XavierianAerospace/Wind_Tunnel_Proyect/Túnel_de_viento.pdf

Diseno Conceptual de T ˜ | unel de Viento de R ´ | afagas ´
para Pruebas Aerodinamicas Subs ´ | onicas ´
Julian Camilo Aranda Garc ´ | ía
Semillero XAE (Xaverian Aerospace Engineering) Pontificia Universidad Javeriana Bogota, Colombia ´

Resumen—El presente documento detalla la justificacion, me- ´
todología y secuencia de diseno de un t ˜ | unel de viento subs ´ | oni- ´
co tipo rafaga (blowdown). El objetivo del t ´ | | unel es permitir ´
la experimentacion y validaci ´ | on aerodin ´ | amica de modelos de ´
cohetería a velocidades aproximadas de 400 km/h. Se plantea una metodología de diseno inverso, partiendo de las restricciones ˜
geometricas de la secci ´ | on de pruebas hacia los sistemas de ´
suministro de presion. ´
Palabras clave—Aerodinamica subs ´ | onica, dise ´ | no inverso, m ˜ | eto- ´
do de Morel, tobera, tunel de r ´ | afaga. ´
I. JUSTIFICACION DEL ´ | MODELO: TUNEL ´ | TIPO RAFAGA ´

Para alcanzar velocidades de prueba de 400 km/h (Mach
≈ 0,32), un tunel de viento de circuito continuo requerir ´ | | | ía una
planta motriz de dimensiones y consumo electrico que exceden ´
la viabilidad tecnica y financiera est ´ | andar de un laboratorio ´
universitario.
Por ello, se ha optado por implementar un modelo tipo rafaga ( ´ blowdown). Este sistema almacena aire a alta presion´ en un tanque mediante un compresor de menor potencia y lo libera controladamente. Esto permite alcanzar las altas velocidades requeridas durante ventanas de tiempo lo suficientemente amplias para la recoleccion de datos mediante ´ sensores de alta tasa de muestreo, optimizando así los recursos espaciales y presupuestales.

II. METODOLOGÍA DE DISENÕ

En aerodinamica, el dimensionamiento de un t ´ | unel de viento ´
se rige por las necesidades de la seccion en la que se evaluar ´ | á
el modelo. Por lo tanto, se ha establecido una metodología de
diseno en orden inverso al flujo del aire, partiendo de la ˜ | unica ´
restriccion geom ´ | etrica inamovible: una secci ´ | on de pruebas con ´
un diametro fijo de ´ | 300 mm.
La secuencia de diseno estructurada es la siguiente: ˜
1. Diseno de la tobera (cono de contracci ˜ | | on). ´
2. Dimensionamiento de la camara de estabilizaci ´ | on. ´
3. Diseno del difusor. ˜
4. Especificacion del tanque de almacenamiento y grupo ´ motocompresor.

III. SECUENCIA Y DESARROLLO DE COMPONENTES

III-A. Tobera de Contraccion´

La tobera tiene la funcion de acelerar el flujo de aire ´
desde la camara de estabilizaci ´ | on hasta la secci ´ | on de pruebas, ´
minimizando las perdidas de presi ´ | on y asegurando un perfil ´
de velocidad uniforme.
En aerodinamica, la Relaci ´ | on de Contracci ´ | on ( ´ | CR) se
define como la proporcion entre las ´ | areas de las secciones ´
transversales de entrada (Ain) y salida (Aout), no linealmente
entre sus diametros. La relaci ´ | on geom ´ | etrica est ´ | a regida por la ´
siguiente expresion: ´

CR =

Ain

Aout

=

π
4 D²
in
π
4 D²
out

=

(︃
Din

Dout )︃2
(1)
Despejando el diametro de entrada ( ´ | Din) para una seccion´
de pruebas restringida a Dout = 300 mm y un CR objetivo de 9:

Din =

√
9 · 300 mm = 3 · 300 mm = 900 mm | (2)
Para la definicion geom ´ | etrica del perfil de contracci ´ | on, se ´
implemento el m ´ | etodo anal ´ | ítico propuesto por Thomas Morel
(1975). Este metodo reemplaza los polinomios de un solo ´ grado por dos curvas cubicas que se acoplan suavemente en un ´ punto de empalme o inflexion ( ´ Xm). Esto permite un control estricto sobre los gradientes de presion adversos en las paredes, ´ mitigando drasticamente el riesgo de desprendimiento de la ´ capa límite (boundary layer separation).
Físicamente, la primera curva (concava) contiene al fluido ´
para iniciar su aceleracion sin descensos bruscos de presi ´ | on´
en la pared, mientras que la segunda curva (convexa) alinea las líneas de corriente para que el aire ingrese a la seccion de ´ pruebas de forma perfectamente horizontal. Las ecuaciones que rigen el perfil radial y(x) a lo largo de la longitud L de la tobera estan definidas por estas dos zonas: ´
Para la zona de entrada (0 ≤ x ≤ Xm):

y1(x) = Rin − C1x

3
(3)

Para la zona de salida (Xm < x ≤ L):

y2(x) = Rout + C2(L − x)

3
(4)

Donde Rin y Rout son los radios de entrada y salida
respectivamente. Los coeficientes geometricos ´ | C1 y C2 se
calculan garantizando que tanto el valor posicional como la pendiente de ambas curvas sean matematicamente continuos ´ en el punto de inflexion´ Xm:

C1 =

Rin − Rout
X²
m · L

(5)

C2 =

Rin − Rout
(L − Xm)

2 · L

(6)

Para el dimensionamiento actual, se establecio una longitud ´ total L = 900 mm (cumpliendo con la relacion´ L/Din = 1) y
un punto de inflexion ubicado en el 55 % de la longitud ( ´ | Xm =
495 mm). Esta asimetría proporciona una zona concava inicial ´ mas extensa para acelerar el aire gradualmente, seguida de ´
una seccion convexa m ´ | as corta que endereza el flujo hacia la ´
seccion de pruebas. El perfil geom ´ | etrico resultante, exportado ´
desde MATLAB, se ilustra en la Figura 1.

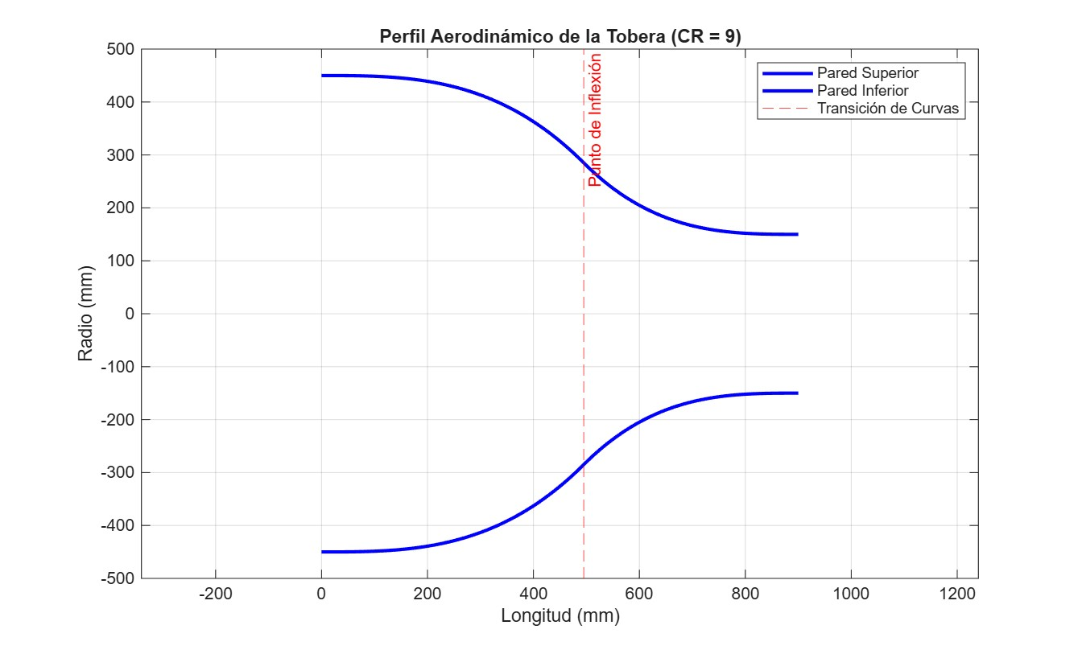
[picture p1: figure]

Figura 1. Perfil aerodinamico de la tobera generado mediante el acople de ´
curvas cubicas de Morel ( ´ | CR = 9).
III-B. Camara de Estabilizaci ´ | on´
La camara de estabilizaci ´ | on es la secci ´ | on de mayor ´ | area ´
transversal del tunel, con un di ´ | ametro interno ´ | Din = 900 mm.
Esta dise ´ | nada para reducir la velocidad del flujo, minimizar ˜
las perdidas de carga y disipar la turbulencia macrosc ´ | opica ´
antes de la contraccion. Por el principio de conservaci ´ | on de ´
la masa para flujo incompresible, la velocidad del aire dentro
de esta camara ( ´ | vin) se reduce de forma inversa a la Relacion´
de Contraccion ( ´ | CR):

vin =

vout
CR =

400 km/h
9

≈ 44,4 km/h (12,3 m/s) (7)

donde vout es la velocidad de prueba (400 km/h) y CR es la
relacion de contracci ´ | on (9). Considerando la densidad del aire ´
en Bogota, aproximadamente ´ | ρ ≈ 0,90 kg/m³
(a ∼ 2600 m
sobre el nivel del mar), la presion din ´ | amica en la c ´ | amara se ´
calcula como:

q =

1
2

ρv²
in =

1
2
(0,90 kg/m³ | )(12,3 m/s)
2 ≈ 68 Pa | (8)
A esta baja presion din ´ | amica, el flujo puede acondicionarse de ´
forma segura antes de la contraccion. Para referencia, al nivel ´ del mar (ρ ≈ 1,225 kg/m³
) la misma velocidad produciría q ≈ 93 Pa, lo que confirma la ventaja de operar en la altitud de Bogota.´
III-B1. Panal de Abejas (Honeycomb): El proposito prin- ´ cipal del honeycomb es eliminar los grandes vortices trans- ´ versales y alinear las líneas de corriente paralelamente al
eje longitudinal del tunel. Su dimensionamiento aerodin ´ | amico ´
depende de dos variables geometricas clave: el di ´ | ametro ´
hidraulico o ancho de la celda ( ´ | dh) y la longitud o espesor
del panal (Lh).
Para asegurar una correcta disipacion de la turbulencia sin ´
inducir una caída de presion excesiva, el di ´ | ametro de la celda ´
(dh) se dimensiona típicamente como el 1 % del diametro de ´
la camara ( ´ | Din):

dh ≈

Din
100

=

900 mm
100
| = 9 mm | (9)
Adoptando un estandar comercial, se define un di ´ | | ametro ´
nominal de celda de:
dh = 9,5 mm | (10)

Para garantizar que el flujo adquiera una direccion comple- ´ tamente axial al atravesar las celdas, la longitud del panal (Lh)
debe cumplir con una relacion de esbeltez ´ | Lh/dh comprendida
entre 6 y 8:

Lh = 6 · dh = 6 · 9,5 mm = 57 mm ≈ 60 mm (11)

Asimismo, para que el panal actue como un enderezador ´
eficiente y no como una restriccion severa, la porosidad o ´ | | area ´
abierta del arreglo (βhc) debe superar el 80 %:

βhc =

Aabierta

Atotal

> 0,80 | (12)
donde Aabierta es el area por donde pasa el aire a trav ´ | | es de ´
los agujeros y Atotal es el area total de la secci ´ | on transversal ´
del panal.
Consideracion de Manufactura e Instalaci ´ | on: ´ | Debido a la
baja velocidad del fluido (12,3 m/s), las cargas aerodinamicas ´ sobre las paredes de las celdas son reducidas. Por ello, el componente se fabricara mediante manufactura aditiva modular en ´ impresoras 3D industriales, controlando un espesor de pared de celda de 0,4 mm a 0,5 mm para maximizar la porosidad.
Detras del panal, el fluido experimenta una p ´ | | erdida de ´
velocidad localizada en los bordes de las celdas, generando
pequenas estelas turbulentas ( ˜ | wakes). Para permitir que dichas
estelas se disipen y el perfil de velocidad se homogenice mediante mezcla viscosa antes de chocar con la primera malla, se debe respetar una distancia libre de seguridad (Xhc−m) derivada empíricamente en la literatura aerodinamica: ´

Xhc−m ≈ 20 · dh = 20 · 9,5 mm = 190 mm (13)

donde Xhc−m es la longitud longitudinal mínima requerida para que el decaimiento exponencial de la turbulencia del panal sea completo antes de incidir sobre la primera malla estabilizadora.
En consecuencia, integrando el espesor del panal de abejas, las distancias de desfase de la turbulencia y los espacios de transicion requeridos entre las mallas estabilizadoras, la longi- ´
tud longitudinal total del tubo de la camara de estabilizaci ´ | | on´
se fija en:

Lcamara = 60 mm (panal)+190 mm+180 mm+180 mm = 610 mm
| | (14)

donde esta longitud total de 610 mm y un diametro interno ´ de 900 mm definen las cotas definitivas para el modelado
volumetrico de la c ´ | amara en el entorno CAD. ´

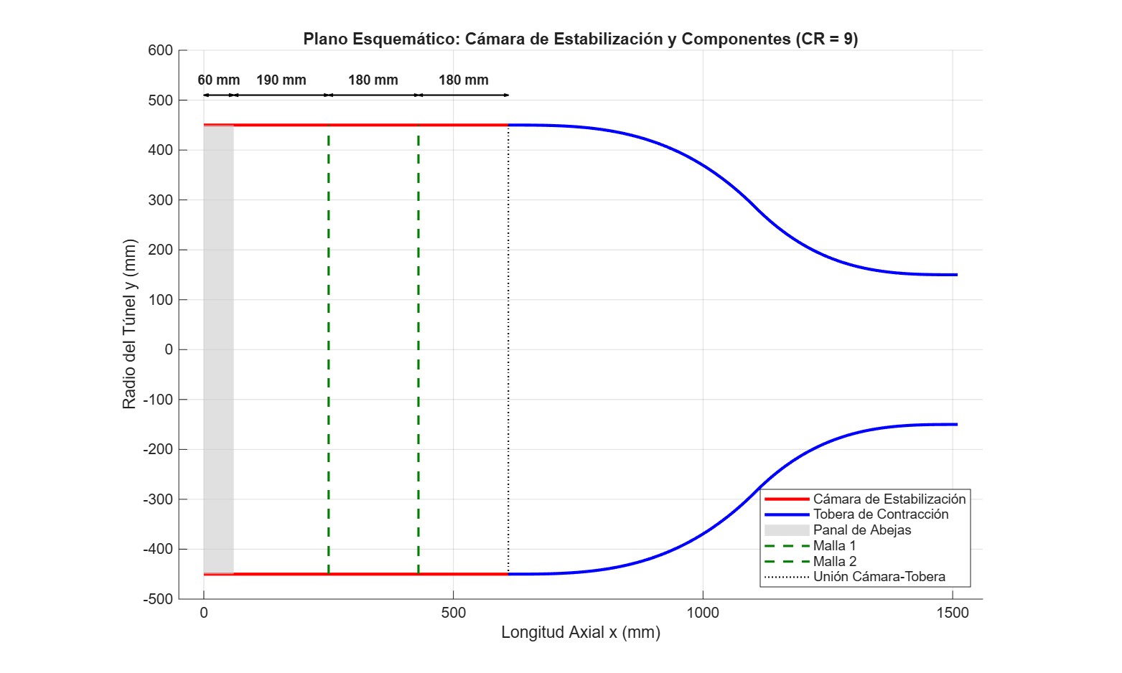
[picture p2: figure]

Figura 2. Plano esquematico de la c ´ | amara de estabilizaci ´ | on con distribuci ´ | on´
longitudinal de componentes: panal de abejas (60 mm), espacios de disipacion´ y mallas estabilizadoras.

III-C. Difusor

Ubicado aguas abajo de la valvula reguladora y aguas ´
arriba de la camara de estabilizaci ´ | on, el difusor tiene como ´
funcion expandir el flujo de aire comprimido proveniente de ´
la tubería de suministro hasta el diametro de la c ´ | amara ( ´ | Din =
900 mm), desacelerandolo y recuperando parte de la presi ´ | | | on´
dinamica antes de ingresar a la zona de acondicionamiento. ´
III-C1. Caudal masico y condiciones de operaci ´ | on: ´ | El
caudal masico requerido en la secci ´ | on de pruebas se obtiene ´
aplicando la ecuacion de continuidad. Considerando que la ´
expansion del aire a alta presi ´ | on desde la v ´ | alvula reguladora ´
induce un enfriamiento termico que eleva la densidad local ´ respecto al ambiente bogotano (ρpruebas ≈ 0,90 kg/m³ ), y
con Dout = 300 mm y vout = 400 km/h = 111,11 m/s:

m˙ = ρpruebasAoutvout = (0,90) (︂π
4

(0,3)²

)︂
(111,11) ≈ 7,07 kg/s
(15)
Para transportar este caudal desde el tanque, se adopta una tubería comercial de 6 pulgadas (Dtuberia = 152,4 mm), con un area transversal de: ´

Atuberia =

π
4

(0,1524)² ≈ 0,01824 m

2
(16)
Fijando una velocidad de diseno en la tuber ˜ | ía de vtuberia =
30 m/s (valor típico para minimizar perdidas por fricci ´ | on sin ´
sobredimensionar la tubería), la densidad necesaria del aire en la tubería se obtiene despejando de la ecuacion de continuidad: ´

ρtuberia =

m˙

vtuberiaAtuberia

=

7,07
(30)(0,01824) ≈ 12,92 kg/m³

(17)
Aplicando la ecuacion de estado de los gases ideales ( ´ | T =
300 K, R = 287 J/kg·K), la presion absoluta en la tuber ´ | ía
resulta:

Ptuberia = ρtuberiaRT = (12,92)(287)(300) ≈ 1,11 MPa ≈ 11,1 bar
| (18)
Considerando las perdidas distribuidas en la tuber ´ | ía y las
perdidas localizadas en la v ´ | alvula reguladora ( ´ | ∆Ptotal | ≈
0,9 bar), la presion de operaci ´ | on del tanque se establece en: ´
Ptanque = Ptuberia + ∆Ptotal ≈ 12 bar | (19)
III-C2. Relacion de expansi ´ | on y longitud: ´ | La relacion de ´
areas del difusor se define como el cociente entre el ´ | | area de ´
salida (camara de estabilizaci ´ | on) y el ´ | area de entrada (tuber ´ | ía
de suministro):

ARdif =

Acamara

Atuberia

=

(︃
| Dcamara

Dtuberia )︃2
| | =

(︃
| | 900
| | 152,4

)︃2
≈ 34,9

(20)
Para un difusor conico convencional, el semi- ´ | | angulo de ´
expansion debe mantenerse por debajo de ´ | | 3,5
- para evitar
el desprendimiento de la capa límite. Fijando un angulo ´ equivalente de expansion´ αeq = 7◦
(correspondiente a un
difusor de gran angular), la longitud requerida es:

Ldif =

Dcamara − Dtuberia
2 tan αeq
| = | 900 − 152,4
| | 2 tan(7◦)

≈ 3, 045 mm ≈ 3,05 m

(21)
III-C3. Perfil geometrico mediante polinomio de quinto ´ orden: A diferencia de la tobera de contraccion, donde se ´ implemento el m ´ etodo de Morel (1975) para controlar el gra- ´ diente favorable de presion, el difusor opera bajo un gradiente ´ de presion adverso que favorece el desprendimiento de la capa ´ límite. Por esta razon, no es aplicable el acople de curvas ´ cubicas de Morel. ´
En su lugar, se implementa un perfil de suavizado polinomi- ´ co de quinto orden (quintic smoothstep), el cual impone continuidad de posicion, pendiente y curvatura tanto en la entrada ´ como en la salida del difusor. Esto distribuye progresivamente
la expansion y evita discontinuidades geom ´ | | etricas que puedan ´
inducir separacion prematura del flujo. ´
El perfil radial y(x) a lo largo de la longitud L esta definido ´ por:

y(x) = Rin+(Rout−Rin)

[︃
| 6

(︂ x
L

)︂5
| | − 15 (︂ x
| | L

)︂4
| | + 10 (︂ x
| | L

)︂3

]︃

(22)
donde Rin = Dtuberia/2 = 76,2 mm es el radio de entrada (tubería), Rout = Dcamara/2 = 450 mm es el radio de
salida (camara) y ´ | L = Ldif = 3, 045 mm es la longitud total
del difusor. Este polinomio satisface las seis condiciones de frontera requeridas:
y(0) = Rin, | y′
(0) = 0, | y′′(0) = 0 | (23)
y(L) = Rout, | y′
(L) = 0, | y′′(L) = 0 | (24)

La pendiente maxima del perfil ocurre en el punto medio ´ (x = L/2) y esta dada por: ´

y

′
max = 1,875 ·

Rout − Rin
L

= 1,875 ·

| | 450 − 76,2
| | 3, 045

≈ 0,230

(25)
Lo que corresponde a un angulo local m ´ | aximo de: ´

αmax = arctan(y

′
max) = arctan(0,230) ≈ 13,0
| | ◦
(26)

Este angulo local, superior al semi- ´ | angulo equivalente de ´
7

◦
, excede el límite practico de adherencia de la capa l ´ | ímite
(α < 3,5

◦
sin control activo). Por lo tanto, se requiere la
instalacion de pantallas internas ( ´ | screens) distribuidas a lo
largo del difusor para energizar la capa límite y prevenir el desprendimiento.
El coeficiente de recuperacion de presi ´ | on ideal para este ´
difusor es:

Cp,ideal = 1 −

1
AR²
dif

= 1 −

1
34,9

2

≈ 0,9992 | (27)
En la practica, con la instalaci ´ | on de 2 a 3 pantallas de poro- ´
sidad controlada, el coeficiente de recuperacion real se estima ´ entre 0.75 y 0.85, valor que sera validado experimentalmente ´ durante la fase de puesta en marcha del tunel. ´
III-C4. Viabilidad mecanica de la tuber ´ | ía de suministro:
Es importante validar que una tubería de 6 pulgadas pueda operar de forma segura a la presion de 12 bar calculada. Esta ´
configuracion es una pr ´ | actica est ´ | andar en sistemas industriales ´
de aire comprimido. Una tubería de acero Schedule 40 de 6”(espesor de pared ≈ 7,11 mm) posee una presion admisible ´ a temperatura ambiente de aproximadamente 28 bar, muy superior a los 12 bar de operacion. Alternativamente, se pue- ´ den emplear tuberías de aluminio comerciales de 6”disenadas ˜ específicamente para redes de aire comprimido a 12 bar. Las conexiones entre la boquilla del tanque, la valvula ´ reguladora y la entrada del difusor se realizaran mediante ´ bridas de 6”. clase 150 segun norma ASME B16.5, las cuales ´ soportan hasta ∼ 19 bar a temperatura ambiente. La boquilla
de salida del tanque debera ser dise ´ | nada y reforzada seg ˜ | un los ´
requerimientos de la norma ASME Seccion VIII (m ´ | etodo de ´
reemplazo de area, UG-37). ´

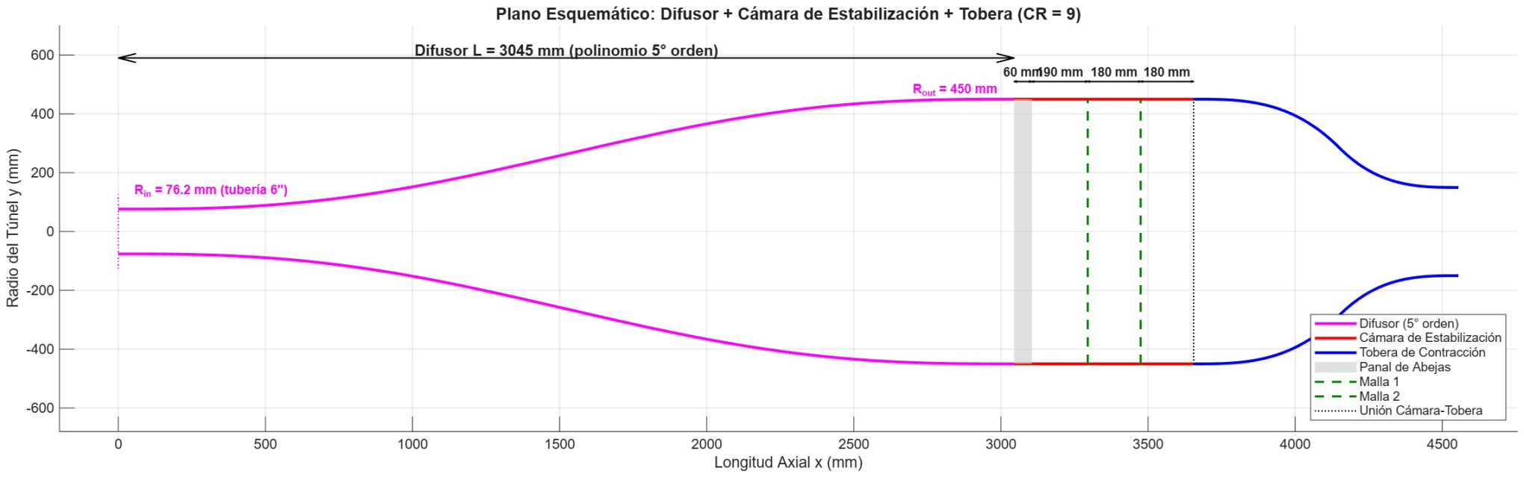
[picture p3: figure]

Figura 3. Plano esquematico del difusor de quinto orden acoplado a la ´
camara de estabilizaci ´ | on y a la tobera de contracci ´ | on. Se observa la expansi ´ | on´
progresiva desde la tubería de 6”(Rin = 76,2 mm) hasta el diametro de la ´
camara ( ´ | Rout = 450 mm) a lo largo de Ldif = 3, 045 mm. Las líneas
discontinuas verdes indican la ubicacion de las mallas estabilizadoras dentro ´ de la camara. ´

III-D. Tanque Presurizado y Compresor
Una vez definidos los componentes aerodinamicos del t ´ | unel ´
y el caudal masico requerido en la secci ´ | on de pruebas ( ´ | m˙ =
7,07 kg/s), es posible dimensionar el sistema de suministro de aire comprimido. Este sistema esta compuesto por un tanque ´
de almacenamiento a alta presion, una v ´ | alvula reguladora de ´
6
un grupo motocompresor encargado de recargar el tanque entre pruebas.
Para seleccionar la configuracion´ optima, se evaluaron cua- ´ tro tiempos de prueba diferentes (t = 10, 15, 20 y 30 s).

A continuacion se presentan las ecuaciones que rigen el ´ dimensionamiento de cada componente.
III-D1. Masa de aire requerida: La masa de aire necesaria para sostener el flujo durante un tiempo de prueba t se obtiene integrando el caudal masico constante: ´
maire = ṁ · t | (28)

III-D2. Volumen del tanque: Aplicando la ecuacion de ´
estado de los gases ideales entre la presion inicial ( ´ | Pi) y la
presion final ( ´ | Pf ) del tanque, el volumen requerido es:

Vtanque =

maire · R · T
Pi − Pf

(29)

donde R = 287 J/(kg·K) es la constante específica del aire, T = 300 K es la temperatura ambiente, Pi = 30 bar es la
presion de carga inicial y ´ | Pf = 15 bar es la presion m ´ | ínima
que debe mantener el tanque para que el regulador sostenga el flujo durante toda la prueba.
III-D3. Dimensiones geometricas del tanque: ´ | Para un tan-
que cilíndrico horizontal con relacion de aspecto ´ | L/D = 1,5
(valor típico comercial), el diametro se obtiene despejando del ´ volumen:

Vtanque =

π
4

D²L =

π
4

D²

(1,5D) = 3π
8

D³
(30)

Despejando el diametro: ´

D =

(︃
8Vtanque
3π

)︃1/3
(31)

Y la longitud correspondiente es:

L = 1,5 · D | (32)

III-D4. Espesor de pared del tanque: Segun la norma ´
ASME Seccion VIII Divisi ´ | on 1, el espesor m ´ | ínimo de pared
para un recipiente cilíndrico sometido a presion interna est ´ | á
dado por:

tpared =

Pi

- R
S · E − 0,6Pi

(33)

donde Pi = 3,0 MPa es la presion de dise ´ | no, ˜ | R = D/2 es el
radio interior, S = 138 MPa es el esfuerzo admisible del acero al carbono a temperatura ambiente y E = 1,0 es la eficiencia de la junta soldada (para soldadura radiografiada al 100 %). III-D5. Peso estimado del tanque: El peso del tanque se estima a partir del volumen de acero utilizado en el cuerpo cilíndrico y los casquetes. Considerando el cuerpo cilíndrico y dos casquetes elipsoidales, el peso aproximado es:
Wtanque ≈ ρacero · π · D · L · tpared · 1,15 | (34)

donde ρacero = 7, 850 kg/m³
es la densidad del acero y el factor 1.15 incluye el peso adicional de los casquetes, boquillas y soportes.
III-D6. Caudal masico del compresor: ´ | El compresor debe
recargar el tanque desde Pf hasta Pi en un tiempo de recarga trec (adoptado como 1 hora). El caudal masico requerido es: ´

m˙ comp =

maire

trec

(35)

III-D7. Caudal volumetrico del compresor: ´ | | El caudal vo-
lumetrico equivalente en condiciones atmosf ´ | ericas de Bogot ´ | á
se obtiene dividiendo el caudal masico entre la densidad del ´ aire local:

Qcomp =

m˙ comp

ρatm

(36)

donde ρatm ≈ 0,87 kg/m³
corresponde a la densidad del aire en Bogota ( ´ ∼ 2, 600 m sobre el nivel del mar). Para expresar el resultado en CFM (pies cubicos por minuto), se aplica: ´

Qcomp[CFM] = Qcomp[m

3
/s] · 2, 118,88 (37)

III-D8. Potencia del compresor: La potencia requerida pa-
ra la compresion se estima mediante el trabajo de compresi ´ | on´
isentropica con una eficiencia global del compresor: ´

Pcomp =

m˙ comp · cp · T
η

[︄(︃
Pi

Patm )︃ γ−1
γ
− 1

]︄
(38)

donde cp = 1, 005 J/(kg·K) es el calor específico del aire a
presion constante, ´ | γ = 1,4 es la relacion de calores espec ´ | íficos,
Patm ≈ 75 kPa es la presion atmosf ´ | erica en Bogot ´ | a y ´ | η = 0,7
es la eficiencia típica de un compresor de dos etapas.
III-D9. Seleccion del tipo de compresor: ´ | Para alcanzar
la presion de operaci ´ | on de 30 bar, se evaluaron dos al- ´
ternativas: compresores de tornillo y compresores de piston´ (reciprocantes). Los compresores de tornillo de una sola etapa típicamente alcanzan presiones maximas de 13 a 15 bar, ´ por lo que requerirían una configuracion de dos etapas para ´ llegar a 30 bar, elevando considerablemente su costo. En contraste, los compresores de piston de dos etapas alcanzan ´ facilmente los 30-40 bar en una sola unidad y tienen un costo ´ significativamente menor.
Por lo tanto, se selecciona un compresor de piston de ´ dos etapas como solucion principal. Este tipo de compresor ´ presenta las siguientes ventajas y consideraciones:

Ventajas: Mayor presion m ´ axima alcanzable por unidad, ´ menor costo inicial, amplia disponibilidad comercial. Consideraciones: Mayor nivel de vibracion (requiere an- ´ claje al piso y union flexible antivibratoria), mayor nivel ´ de ruido (se recomienda instalar en cabina insonorizada o cuarto aparte) y flujo pulsante (amortiguado por el volumen del tanque).

III-D10. Comparacion de alternativas: ´ | Aplicando las
ecuaciones anteriores para los cuatro tiempos de prueba evaluados, se obtiene la Tabla I.

Tabla I
COMPARACION DE ALTERNATIVAS DE TIEMPO DE PRUEBA PARA EL T ´ | | | | UNEL ´
TIPO RAFAGA ´ | .
Parametro | 10 s | 15 s | 20 s | 30 s ´
Masa de aire (kg) | 70.7 | 106.1 | 141.4 | 212.1
Volumen del tanque (m³
) | 4.06 | 6.09 | 8.12 | 12.17
Diametro del tanque (m) | 1.51 | 1.73 | 1.90 | 2.18 ´
Longitud del tanque (m) | 2.27 | 2.60 | 2.86 | 3.27
Espesor de pared (mm) | 16.5 | 18.9 | 20.8 | 23.8
Peso del tanque (kg) | 2,860 | 4,190 | 5,530 | 8,060
Potencia del compresor (kW) | 15.8 | 23.7 | 31.6 | 47.4
Caudal del compresor (CFM) | 48 | 72 | 96 | 144
Viabilidad de instalacion | Alta | Alta | Media | Baja ´
Costo relativo | Bajo | Medio | Alto | Muy alto

Como se observa, el tiempo de prueba de 15 segundos representa el punto de equilibrio entre capacidad experimental
y viabilidad tecnica. Un tanque de ´ | 6,09 m³
con un peso
de ∼ 4,2 toneladas puede instalarse en un laboratorio universitario sin requerir cimentacion especial, y un compresor ´
de piston de dos etapas de ´ | 24 kW es compatible con la
infraestructura electrica t ´ | ípica de una facultad de ingeniería.
Por el contrario, la opcion de 30 segundos requiere un tanque ´
de mas de 8 toneladas y un compresor de ´ | 47 kW, lo que
eleva considerablemente los costos y compromete la viabilidad del proyecto. Las opciones de 20 y 30 segundos quedan descartadas por su elevado peso, volumen y requerimientos de potencia.

IV. ESTRATEGIAS DE MANUFACTURA
Para materializar el diseno aerodin ˜ | | amico dentro de las li- ´
mitaciones tecnicas y presupuestales de un laboratorio univer- ´ sitario, se han definido los siguientes procesos de fabricacion´ para los componentes principales.

IV-A. Tobera de Contraccion´
Dada la complejidad geometrica de la doble curvatura (perfil ´ de Morel) y las dimensiones exigidas por la relacion de ´
contraccion ( ´ | Din = 900 mm, L = 900 mm), la fabricacion´
en lamina met ´ | alica rolada o mecanizado CNC directo excede ´
la viabilidad.
Se plantea como estrategia principal de manufactura la
tecnica de moldeo por deposici ´ | on de materiales compuestos ´
sobre un nucleo positivo ( ´ | molde macho). El procedimiento
propuesto consiste en:
1. Fabricacion del n ´ | ucleo: ´ | Impresion 3D por segmentos ´
del volumen interior de la tobera (utilizando polímeros estandar como PLA o ASA), o alternativamente, el ´ mecanizado CNC en espuma de alta densidad, sujeto a la disponibilidad de los talleres de la facultad.
2. Acondicionamiento superficial: Ensamblaje, masillado y lijado exhaustivo del nucleo hasta obtener un acabado ´ de alta lisura, mitigando cualquier escalon o defecto que ´ pueda inducir turbulencia.
3. Laminado estructural: Aplicacion de agentes desmol- ´ dantes seguidos de capas sucesivas de fibra de vidrio y
resina epoxica sobre el n ´ | ucleo. ´

4. Desmolde: Extraccion del n ´ | ucleo, resultando en una ´
tobera autoportante cuya superficie interna copiara exac- ´ tamente el acabado espejo del molde, cumpliendo con los requerimientos de rugosidad aerodinamica de la capa ´ límite.

IV-B. Difusor

El difusor comparte la misma complejidad geometrica que ´ la tobera, al estar definido por un polinomio de quinto orden con doble curvatura. Por lo tanto, se implementa la misma estrategia de manufactura: nucleo positivo impreso en 3D por ´ segmentos, acondicionamiento superficial mediante masillado y lijado, y laminado estructural con fibra de vidrio y resina epoxica. ´
Debido a la longitud total de 3, 045 mm, el nucleo se fabri- ´
cara en al menos 3 segmentos que se ensamblar ´ | an mediante ´
bridas internas y se alinearan con pines de centrado para ´ garantizar la continuidad del perfil. Las pantallas internas de
control de capa límite se fabricaran en malla met ´ | alica de acero ´
inoxidable y se instalaran entre los segmentos del difusor ´ durante el ensamblaje.
IV-C. Camara de Estabilizaci ´ | on´
La camara de estabilizaci ´ | on es un cilindro recto de ´ | 900 mm
de diametro interno y ´ | 610 mm de longitud, lo cual simplifica
considerablemente su fabricacion. Se plantean dos alternativas: ´
Tubería comercial de gran diametro: ´ | Adquisicion de ´
un tubo de acero al carbono o aluminio de 900 mm de diametro nominal, cortado a la longitud requerida y con ´ bridas soldadas en ambos extremos para el acople con el difusor y la tobera.
Laminado en fibra de vidrio: Para reducir peso y costo, se puede fabricar mediante laminado sobre un mandril cilíndrico, similar al proceso de la tobera.

El panal de abejas se fabricara mediante manufactura ´ aditiva modular en impresoras 3D, con un diametro de celda ´ de 9,5 mm, espesor de pared de 0,4 a 0,5 mm, y una porosidad superior al 80 %. Se imprimira en segmentos que se ´
ensamblaran dentro de la c ´ | amara. Las ´ | mallas estabilizadoras
se fabricaran en malla met ´ | alica de acero inoxidable con una ´
porosidad del 60 al 70 %, montadas en marcos circulares que se insertan en las posiciones longitudinales definidas (x = 250 mm y x = 430 mm).

IV-D. Sistema de Suministro de Aire

El tanque de almacenamiento y el compresor no se fabrican, sino que se adquieren comercialmente. El tanque se especifica
como un recipiente a presion de ´ | 6, 000 L (∼ 1, 600 galones)
con presion de dise ´ | no de ˜ | 30 bar, certificado segun ASME ´
Seccion VIII Div. 1 (sello U) y con boquilla de salida de ´ 6”. El compresor se especifica como una unidad de piston de ´ dos etapas, 24 kW, 30 bar, ∼ 72 CFM, con secador de aire y filtros integrados.

IV-E. Ensamblaje y Montaje
El ensamblaje del tunel se realizar ´ | a mediante bridas ator- ´
nilladas entre cada componente (difusor-camara-tobera), con ´ empaques de caucho o teflon para garantizar la estanqueidad. ´ El conjunto se montara sobre una estructura de perfiles de ´ acero estructural (tipo perfil en C o cuadrado), apoyada sobre amortiguadores de vibracion para aislar las vibraciones del ´ compresor y del flujo. La alineacion axial entre componentes ´ se garantiza mediante pines de centrado en las bridas.
La seccion de pruebas se dise ´ | nar ˜ a como un m ´ | odulo inter- ´
cambiable con ventanas opticas de acr ´ | ílico o vidrio templado
para visualizacion con t ´ | ecnicas ´ | opticas (schlieren, PIV) y ´
con puertos de instrumentacion para sensores de presi ´ | on y ´
temperatura.

REFERENCIAS

[1] J. B. Barlow, W. H. Rae, Jr., and A. Pope, Low-Speed Wind Tunnel Testing, 3rd ed. New York, NY, USA: Wiley, 1999.
[2] R. D. Mehta and P. Bradshaw, “Design rules for small low speed wind tunnels,” The Aeronautical Journal, vol. 83, no. 827, pp. 443–449, Nov. 1979.
[3] A. Pope and K. L. Goin, High-Speed Wind Tunnel Testing. New York, NY, USA: Wiley, 1965.
[4] T. Morel, “Comprehensive design of axisymmetric wind tunnel contractions,” Journal of Fluids Engineering, vol. 97, no. 2, pp. 225–233, Jun. 1975, doi: 10.1115/1.3447255.
[5] E. G. Tulapurkara and V. V. K. Bhalla, “Experimental investigation of Morel’s method for wind tunnel contractions,” Journal of Fluids Engineering, vol. 120, no. 1, pp. 45–49, 1998.
