XavierianAerospace/Wind_Tunnel_Proyect/Tubo_D300mm_L1500mm.SLDPRT

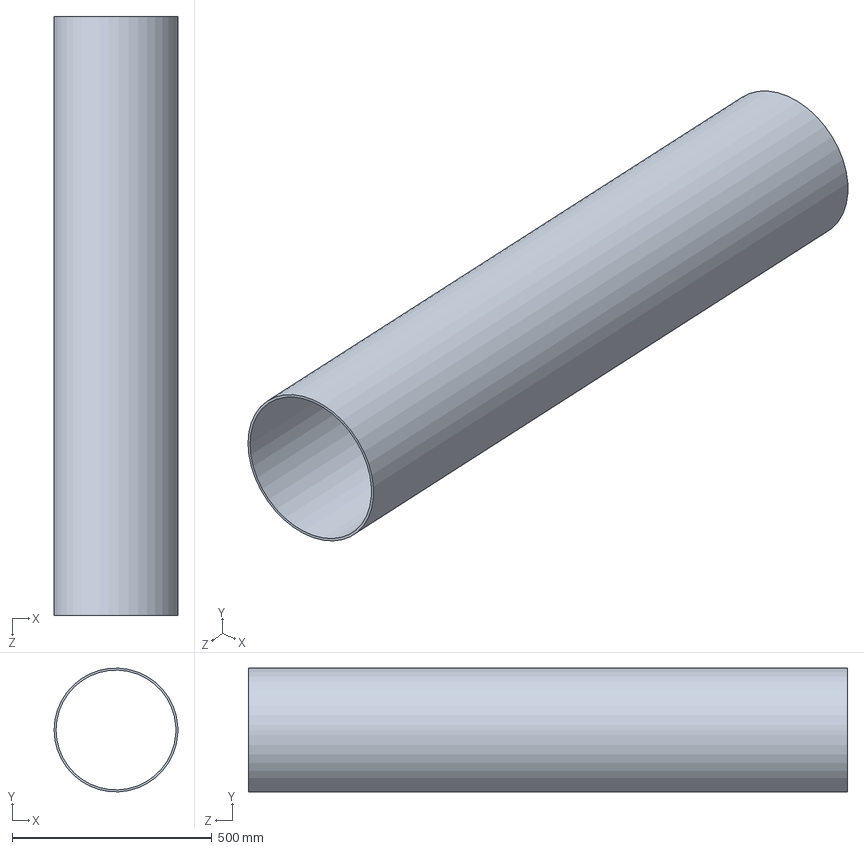
[picture p4: CAD file, 2026-09-28]
Tubo_D300mm_L1500mm.SLDPRT
310.0 x 309.7 x 1500.0 mm
