XavierianAerospace/Wind_Tunnel_Proyect/Motor Brushless soporte.STL

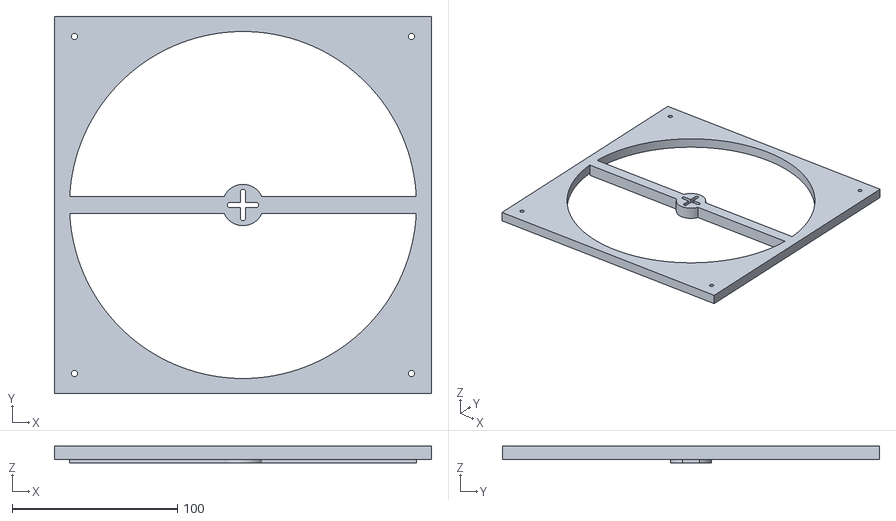
[picture p5: CAD file, 2026-04-20]
Motor Brushless soporte.STL
228.2 x 228.2 x 10.0
